HexabitzPlatform/H0FR6x-Hardware/README.md

# H0FR60-Hardware
Hexabitz AC Solid State Relay Module Hardware Design
