HexabitzPlatform/H0FR6x-Hardware/H0FR6/Released/BOM/H0FR60.xlsx

Qty | Comment | Designator | Description | MFN | MPN | OCTOPART_URL | Qty
5 | 100nF | C3, C5, C6, C8, C9 | CAP CER 10% X7R 0603 | KEMET | C0603C104K8RACTU | https://octopart.com/c0603c104k8ractu-kemet-145075?r=sp&s=9bS9ASSwSEqMCE9KBEQZ0g
1 | 1.00uF | C2 | CAP CER 1UF 16V X7R 0805 | Yageo | CC0805KKX7R7BB105 | https://octopart.com/cc0805kkx7r7bb105-yageo-8376555?r=sp&s=YKl1wwtkROau_X5nniH2ig
2 | 4.7uF | C4, C7 | CAP CER 4.7UF 25V X6S 0805 | Murata | GRM21BC81E475KA12L | https://octopart.com/grm21bc81e475ka12l-murata-10331911?r=sp&s=RY3qZSD8T6mG6TC9CHI5qQ
1 | 10nF | C1 | CAP CER 10% X7R 0603 | KEMET | C0603C103K5RACTU | https://octopart.com/c0603c103k5ractu-kemet-133094?r=sp&s=R_iPBxLnSmGqhkU2rIMFpg
1 | VLMS1300-GS08 | D1 | Red 0603 130ｰ Clear 54 mcd 2 V Surface Mount ChipLED ; | Vishay | VLMS1300-GS08 | https://octopart.com/vlms1300-gs08-vishay-21709201?r=sp&s=_gcP4_q8T1SC6PJQPTQ9yA
1 | VLMY1300-GS08 | D2 | Yellow 0603 130ｰ Clear 54 mcd 2 V Surface Mount ChipLED ; | Vishay | VLMY1300-GS08 | https://octopart.com/vlmy1300-gs08-vishay-21709204
1 | FB-TDK_MMZ1608Y300B | FB1 | Ferrite Beads Multi-Layer 30Ohm 25% 100MHz 1.5A 50mOhm DCR 0603 | TDK | MMZ1608Y300B | https://octopart.com/mmz1608y300b-tdk-368280?r=sp&s=cd9_2ZEqQ9q9UNBuQgHAiA
1 | TE Connectivity | P2 | EUROSTYLE TB,HEADER,GREY,2 POS | TE Connectivity | 1546111-2 | https://octopart.com/1546111-2-te+connectivity-40393355
1 | 270.0R | R1 | Thick Film Resistors - SMD 0603 | Yageo | RC0603FR-07270RL | https://octopart.com/search?q=RC0603FR-07270RL&start=0
1 | 0.0R | R2 | Thick Film Resistors - SMD 0603 | Yageo | RC0603JR-070RL | https://octopart.com/rc0603jr-070rl-yageo-1241539?r=sp&s=X2NteqRjRNWrnx42Y0aliA
1 | 10.0K | R3 | Thick Film Resistors - SMD 0603 | Yageo | RC0603JR-0710KL | https://octopart.com/search?q=RC0603JR-0710KL&start=0
1 | 2.4k | R4 | Thick Film Resistors - SMD 0603 | Yageo | RC0603JR-070RL | https://octopart.com/search?q=RC0402FR-071KL&start=0
1 | 110.0R | R5 | Thick Film Resistors - SMD 0603 | Yageo | RC0402FR-07100RL | https://octopart.com/search?q=RC0402FR-07100RL&start=0
1 | 180.0R | R6 | Thick Film Resistors - SMD 0603 | Yageo | RC0402FR-07100RL | https://octopart.com/search?q=RC0402FR-071ML&start=0
1 | MMBT3904LT1 | Q1 | TRANS NPN 40V 0.2A SOT23 | ON Semiconductor | MMBT3904LT1G | http://octopart.com/mmbt3904lt1g-on+semiconductor-3280
1 | STM32F091CBU6 | U1 | IC MCU 32BIT 128KB FLASH 48QFPN | STMicroelectronics | STM32F091CBU6 | https://octopart.com/stm32f091cbu6-stmicroelectronics-51988677?r=sp&s=bU6fpgsrTZOxHyt7jkfh3w
1 | AQH3213ASOP8 | U2 | AH-H Series SPST 1.2 A 600 V Surface Mount Zero Cross State Relay - SMD-8 | Panasonic | AQH3213A | http://octopart.com/aqh3213a-panasonic-39432588
1 | XTALL_CSTCE8M00G52 | X1 | MURATA CSTCE8M00G52-R0 RESONATOR, SMD, 8MHZ ; | Murata | CSTCE8M00G52Z-R0 | https://octopart.com/cstce8m00g52z-r0-murata-17755941?r=sp&s=JDnNJnrHQhyS8Zk4ofFWXw
