HexabitzPlatform/H0FR6x-Hardware/H0FR6/Documentation/H0FR6 Schematics.pdf

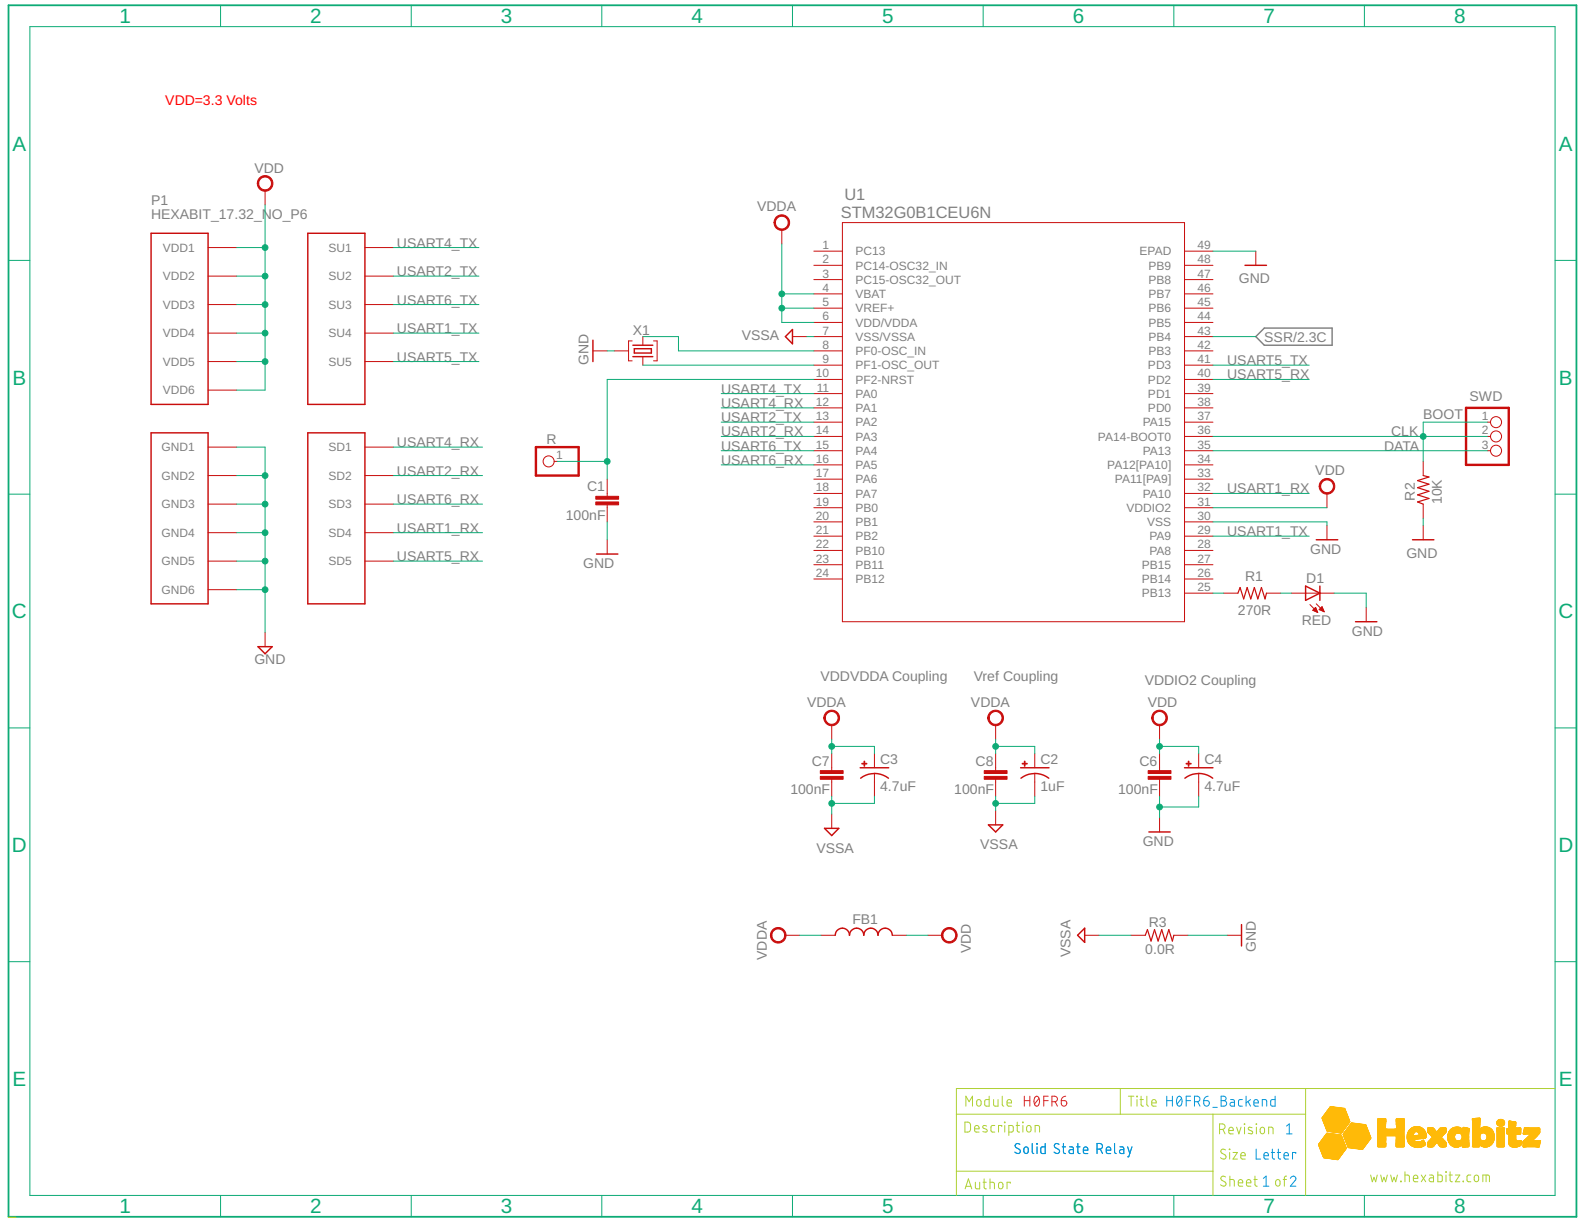
[picture p1: page 1]

5 | 45 PB7
6 | 44 PB6

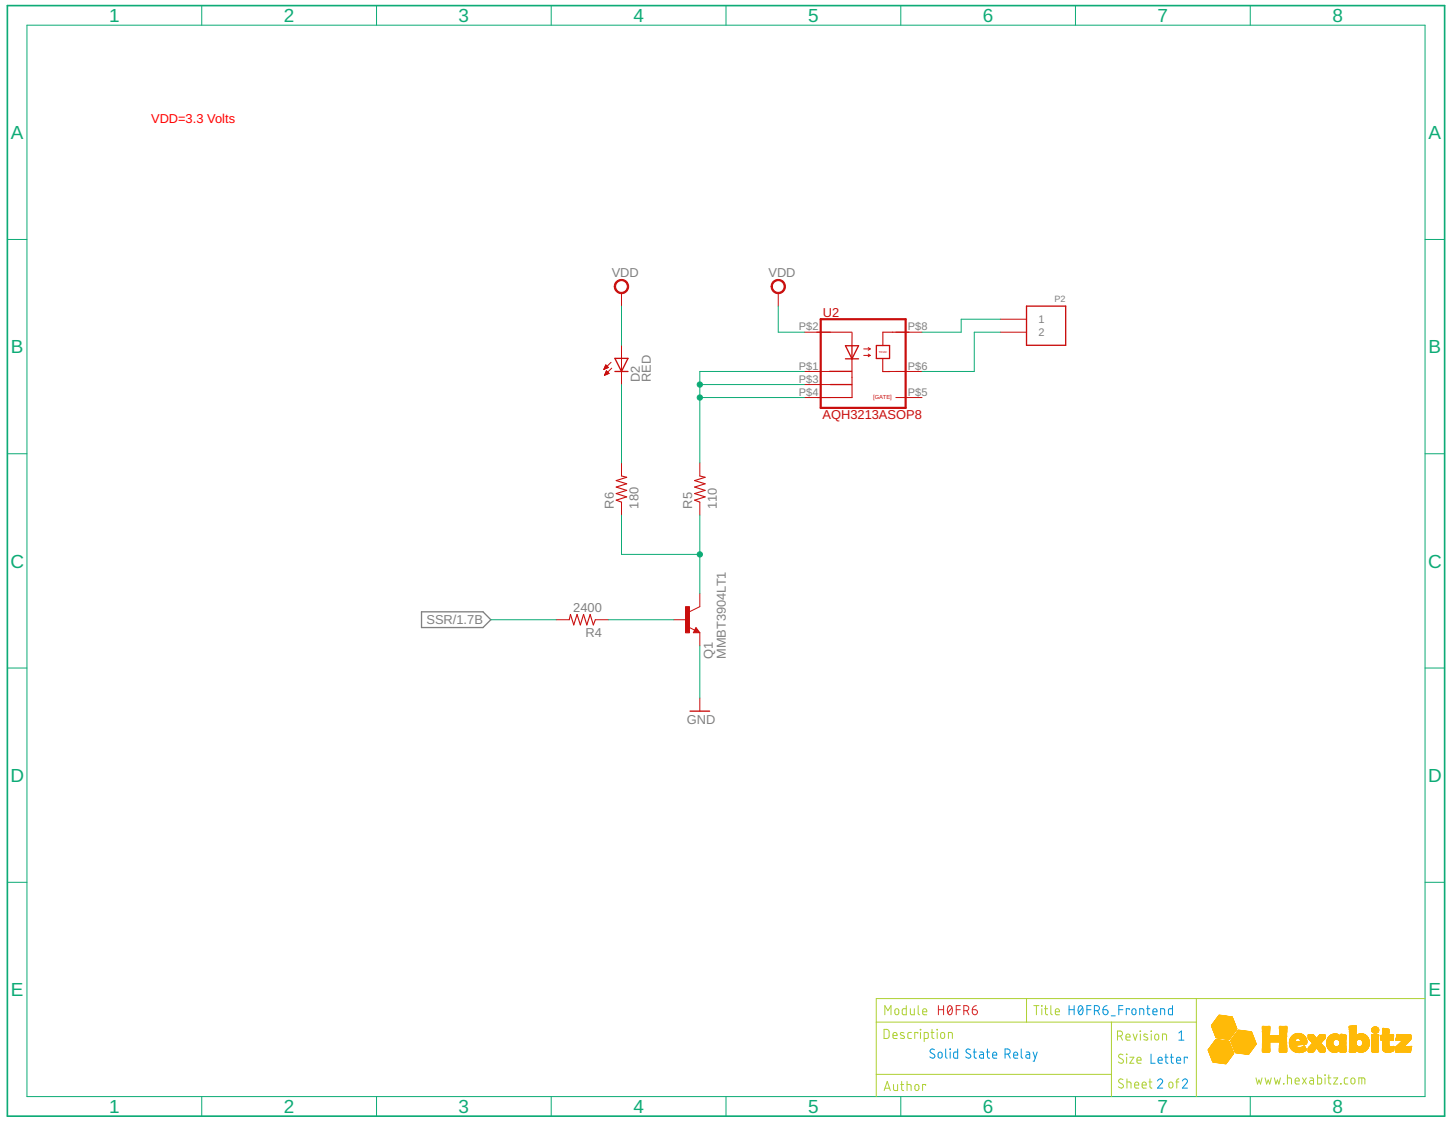
[picture p2: page 2]
