HexabitzPlatform/H0FR6x-Hardware/H0FR6/Design/H0FR6.brd

## EAGLE design H0FR6/Design/H0FR6.brd (2024-02-17)

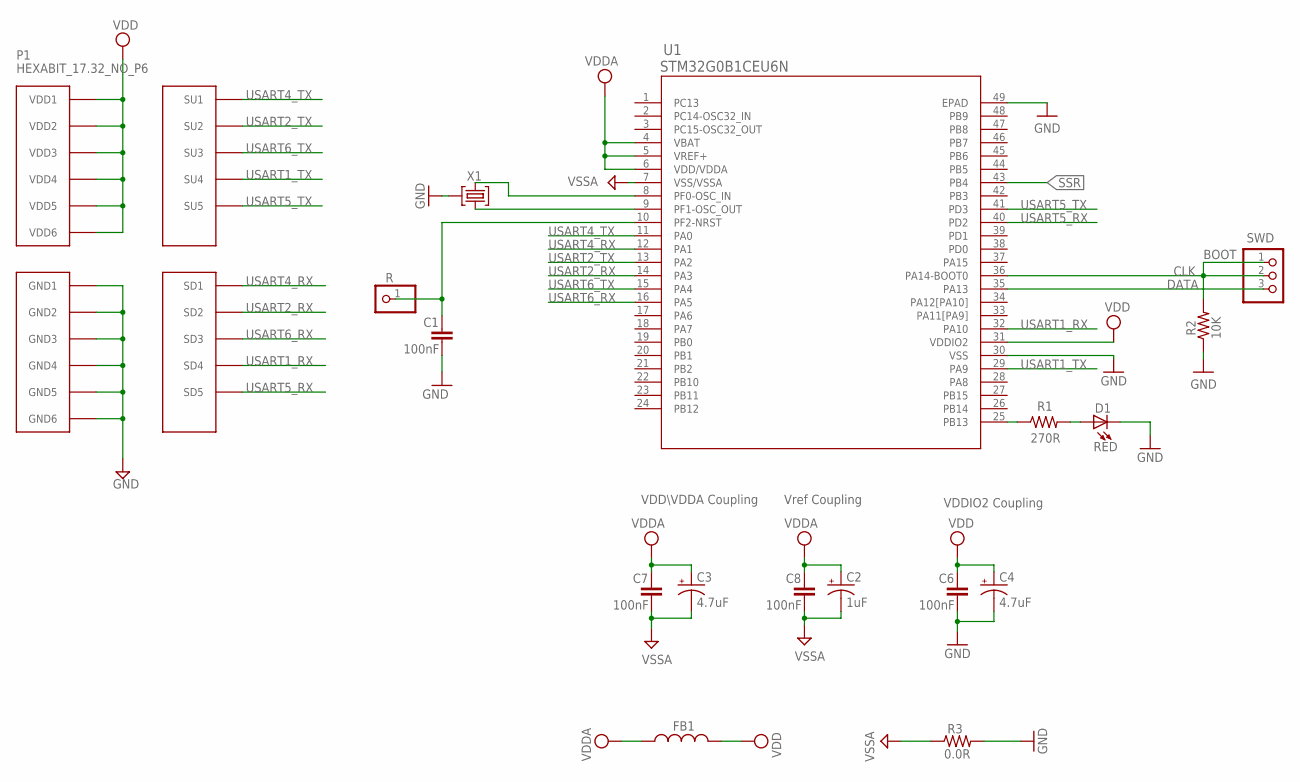
[picture p3: schematic H0FR6.sch, sheet 1]

Parts:
C1, C6, C7, C8: 100nF; C-0603
C2: 1uF; C-0805-POL
C3, C4: 4.7uF; C-0805-POL
D1: RED; VLMS1300-GS08; MPN VLMS1300-GS08
FB1: FB-0603
P1: HEXABIT_17.32_NO_P6
R: R; 1X01
R1: 270R; R-0603
R2: 10K; R-0603
R3: 0.0R; R-0603
SWD: PINHD-1X3; 1X03
U1: STM32G0B1CEU6N; HEXABITZ_ICS_QFN_B1CEU6_STM-L
X1: XTALL_CSTCE8M00G52

Connections:
CLK: R2.2, SWD.1, SWD.2, U1.36 (PA14-BOOT0)
DATA: SWD.3, U1.35 (PA13)
GND: C1.2, C4.2 (-), C6.2, D1.C, P1.PAD_PD7 (GND1), P1.PAD_PD8 (GND2), P1.PAD_PD9 (GND3), P1.PAD_PD10 (GND4), P1.PAD_PD11 (GND5), P1.PAD_PD12 (GND6), R2.1, R3.2, U1.30 (VSS), U1.49 (EPAD), X1.P$2 (2); also elsewhere on the board
unnamed: D1.A, R1.2
unnamed: C1.1, R.1, U1.10 (PF2-NRST)
unnamed: R1.1, U1.25 (PB13)
unnamed: U1.9 (PF1-OSC_OUT), X1.P$1 (1)
unnamed: U1.8 (PF0-OSC_IN), X1.P$3 (3)
SSR: U1.43 (PB4); also elsewhere on the board
USART1_RX: P1.PAD_PD4 (SD4), U1.32 (PA10)
USART1_TX: P1.PAD_PU4 (SU4), U1.29 (PA9)
USART2_RX: P1.PAD_PD2 (SD2), U1.14 (PA3)
USART2_TX: P1.PAD_PU2 (SU2), U1.13 (PA2)
USART4_RX: P1.PAD_PD1 (SD1), U1.12 (PA1)
USART4_TX: P1.PAD_PU1 (SU1), U1.11 (PA0)
USART5_RX: P1.PAD_PD5 (SD5), U1.40 (PD2)
USART5_TX: P1.PAD_PU5 (SU5), U1.41 (PD3)
USART6_RX: P1.PAD_PD3 (SD3), U1.16 (PA5)
USART6_TX: P1.PAD_PU3 (SU3), U1.15 (PA4)
VDD: C4.1 (+), C6.1, FB1.2, P1.PAD_PU7 (VDD1), P1.PAD_PU8 (VDD2), P1.PAD_PU9 (VDD3), P1.PAD_PU10 (VDD4), P1.PAD_PU11 (VDD5), P1.PAD_PU12 (VDD6), U1.31 (VDDIO2); also elsewhere on the board
VDDA: C2.1 (+), C3.1 (+), C7.1, C8.1, FB1.1, U1.4 (VBAT), U1.5 (VREF+), U1.6 (VDD/VDDA)
VSSA: C2.2 (-), C3.2 (-), C7.2, C8.2, R3.1, U1.7 (VSS/VSSA)

Notes on the sheet:
Vref Coupling
VDDIO2 Coupling
VDD\VDDA Coupling
BOOT

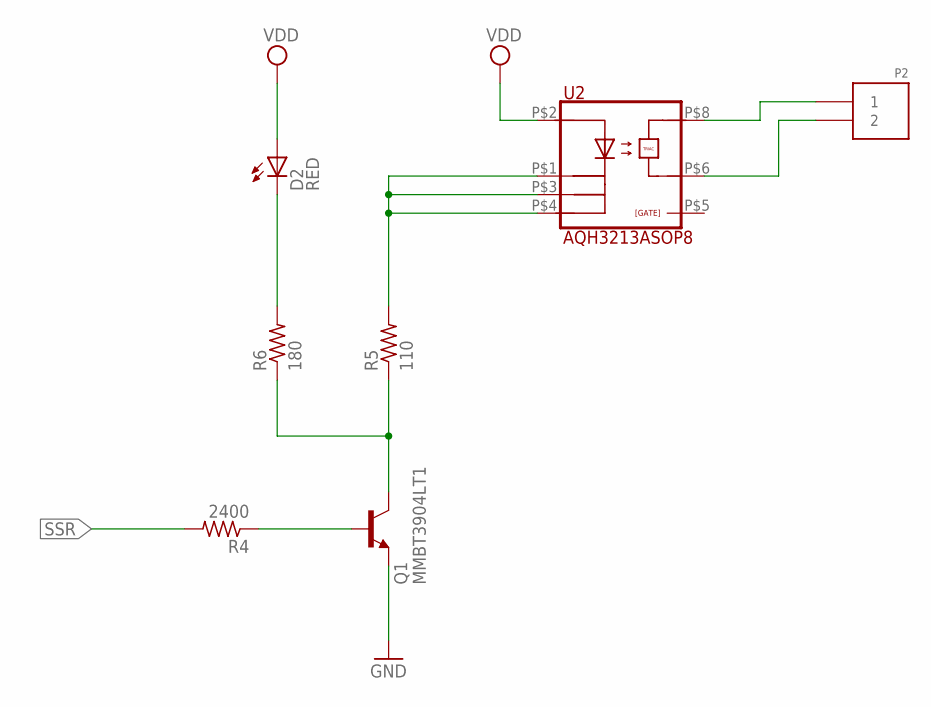
[picture p4: schematic H0FR6.sch, sheet 2]

Parts:
D2: RED; VLMS1300-GS08; MPN VLMY1300-GS08
P2: 1546111-2
Q1: MMBT3904LT1; VOLTAGE_RATING_DC 40.0 V; MPN MMBT3904LT1G
R4: 2400; R-0603; TOLERANCE ±5%; MPN RC0603JR-070RL
R5: 110; R-0603; TOLERANCE ±1%; MPN RC0402FR-07100RL
R6: 180; R-0603; TOLERANCE ±5%; MPN RC0402FR-07100RL
U2: AQH3213ASOP8; AQH3213A

Connections:
GND: Q1.2 (E); also elsewhere on the board
unnamed: P2.1, U2.P$8
unnamed: P2.2, U2.P$6
unnamed: D2.C, R6.2
unnamed: R5.2, U2.P$1, U2.P$3, U2.P$4
unnamed: Q1.3 (C), R5.1, R6.1
unnamed: Q1.1 (B), R4.1
SSR: R4.2; also elsewhere on the board
VDD: D2.A, U2.P$2; also elsewhere on the board

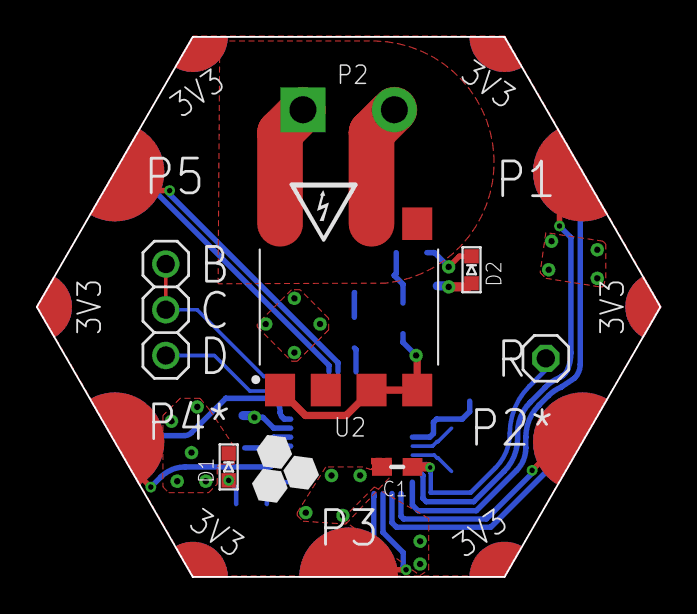
[picture p5: board H0FR6.brd from above]

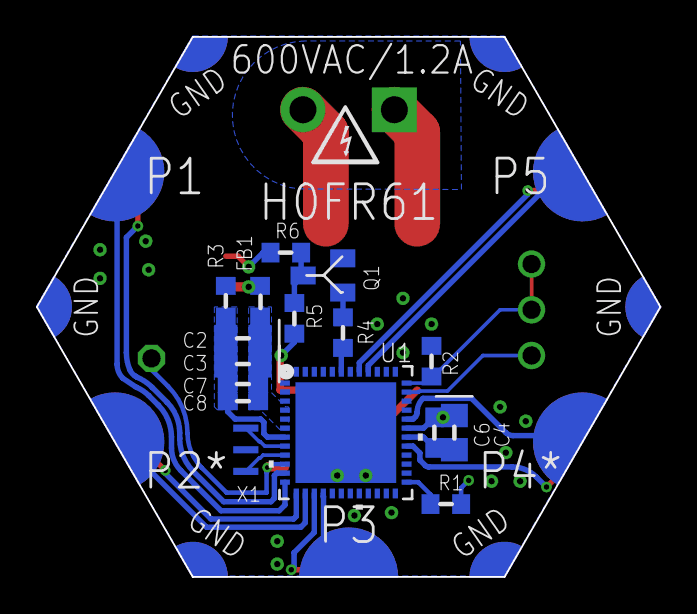
[picture p6: board H0FR6.brd from below]

Board: 2 copper layers, 34.6 x 30.0 mm, 24 parts (16 on the bottom side), 28 nets.
