HexabitzPlatform/H0FR6x-Hardware/(commit log)

2019-05-23 First release rev 0
    [H0FR60.brd, H0FR60.sch, H0FR60.xlsx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]
2024-02-17 -Changing the MCU to STM32G0B1CEU6N
    [H0FR6.brd, H0FR6.sch, H0FR60.brd, H0FR60.sch, H0FR60.xlsx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]
